EWA-Mechatronics/ME462-Project/README.md

# ME462-Project
Middle East Technical University ME462 - Mechatronic Design Project; Mobile Robot Arena
