EWA-Mechatronics/ME462-Project/Robot/CAD/Readme.md

STL files to be 3D printed and the assembly video is available.  
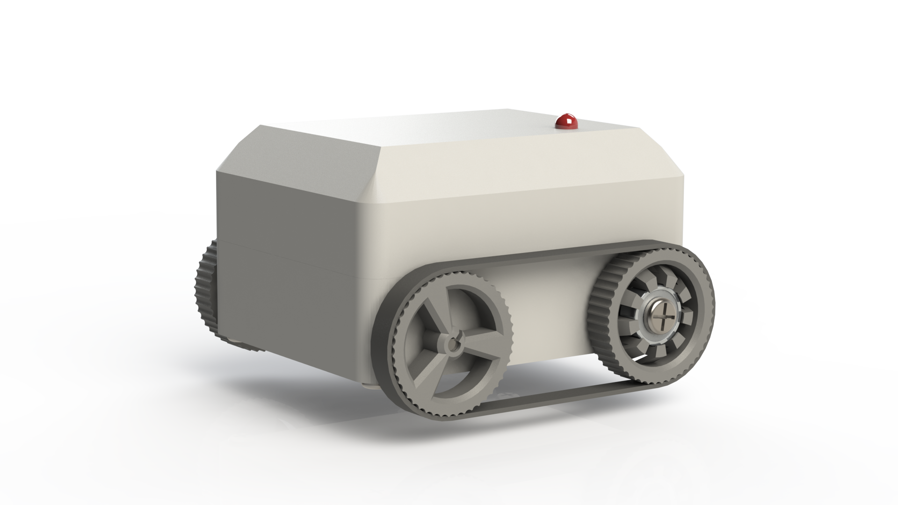
[picture p1: Robot/CAD/render1.png]
  
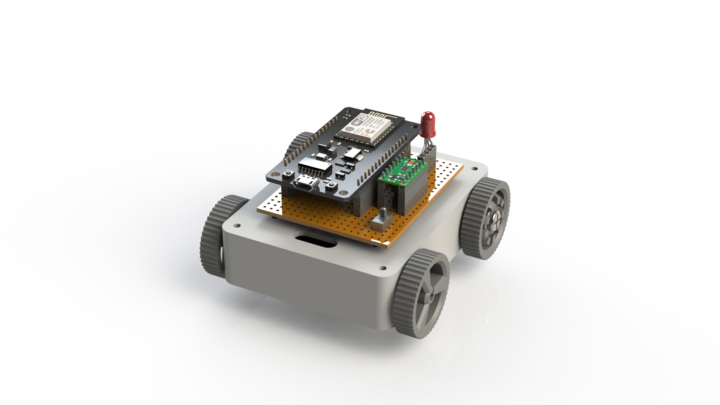
[picture p2: Robot/CAD/render2.png]
