EWA-Mechatronics/ME462-Project/Morphological-Solutions-for-Arena&Robot-Types.md

# Morphological Solutions for Arena&Robot Types

  1. Scenario adapter device
      - Projector
      - Monitor
      
  2. Robot Type
      - Classical
      - Dummy
      
  3. Image Capture Tool
      - Camera
      
  4. Charging of Robots
      - Changeable Battery
      - Laser-beam
      - Magnetic Resonance Coupling
      
  5. Physical Arena Type
      - Frictionless Area
      - Ground (Cathode)
      - Conveyor
      - Monitor
