EWA-Mechatronics/ME462-Project/Functional-Decomposition-for-Arena&Robot-Types.md

# Functional Decomposition for Arena&Robot Types

  1. Scenario adapter device

  2. Robot Type

  3. Image Capture Tool

  4. Charging of Robots

  5. Physical Arena Type
