EWA-Mechatronics/ME462-Project/Software/Webots.md

# What is Webots ?

Webots is a open source professional mobile robot simulation software package. 
It offers a rapid prototyping environment, that allows the user to create 3D virtual worlds with physics properties.
Users can add obstacles and robots to the simulation. Moreover, robots may be equipped with a number of sensor and actuator devices,
such as distance sensors, drive wheels, cameras, motors, touch sensors, etc.
Finally, users can program each robot individually.

Please, visit the [User Guide](https://cyberbotics.com/doc/guide/index) of the Webots to have a deeper understanding.

# Getting Started to the Webots

It is essantial to understand the Webots to understandü this project, since in this project we will also build a simulaiton
to simulate the same processes from the real world. Moreover, we will use this simulation to get desired sensor values. Finally, we want to use
the power of being the open source with Webots.

Please, visit the offical [Tutorials](https://cyberbotics.com/doc/guide/tutorials) of the Webots to get basic understandings about Webots.
