EWA-Mechatronics/ME462-Project/Robot/Functional Decompositon & Morphological Chart.md

**Mobile Robot Functional Decomposition**
1. Actuating the wheels to move
2. To store power
3. Microcontroller
4. To recharge itself
5. To indicate status

**Concepts**
1. Actuating the wheels to move
    1. DC Geared Motor
    2. RC Servo Motor
    3. Stepper Motor

2. To store power
    1. 18650 Li-ion Battery
    2. 14500 Li-ion Battery
    3. Li-Po Battery of appropriate size

3. Microcontroller
    1. Arduino Nano
    2. Raspberry Pi Zero
    3. NodeMCU
    4. ESP-12E

4. To recharge itself
    1. Wireless charger
    2. Physical Contact Charge

5. To indicate status
    1. Addressable LED (NeoPixel)
    2. RGB LED
    3. Buzzer

**Morphological Chart**

| **Functions / Solutions** | 1 | 2 | 3 | 4 |
| --- | :---: | :---: | :---: | :---: |
| 1. Actuating the wheels to move | DC Geared Motor | RC Servo Motor |Stepper Motor|
| 2. To store power | 18650 Li-ion Battery | 14500 Li-ion Battery | Li-Po Battery |  
| 3. Microcontroller | Arduino Nano | Raspberry Pi Zero | NodeMCU | ESP-12E |
| 4. To recharge itself | Wireless charger | Physical Contact Charge |
| 5. To indicate status | Addressable LED | RGB LED | Buzzer |
