EWA-Mechatronics/ME462-Project/Robot/robot-circuit-diagram.png

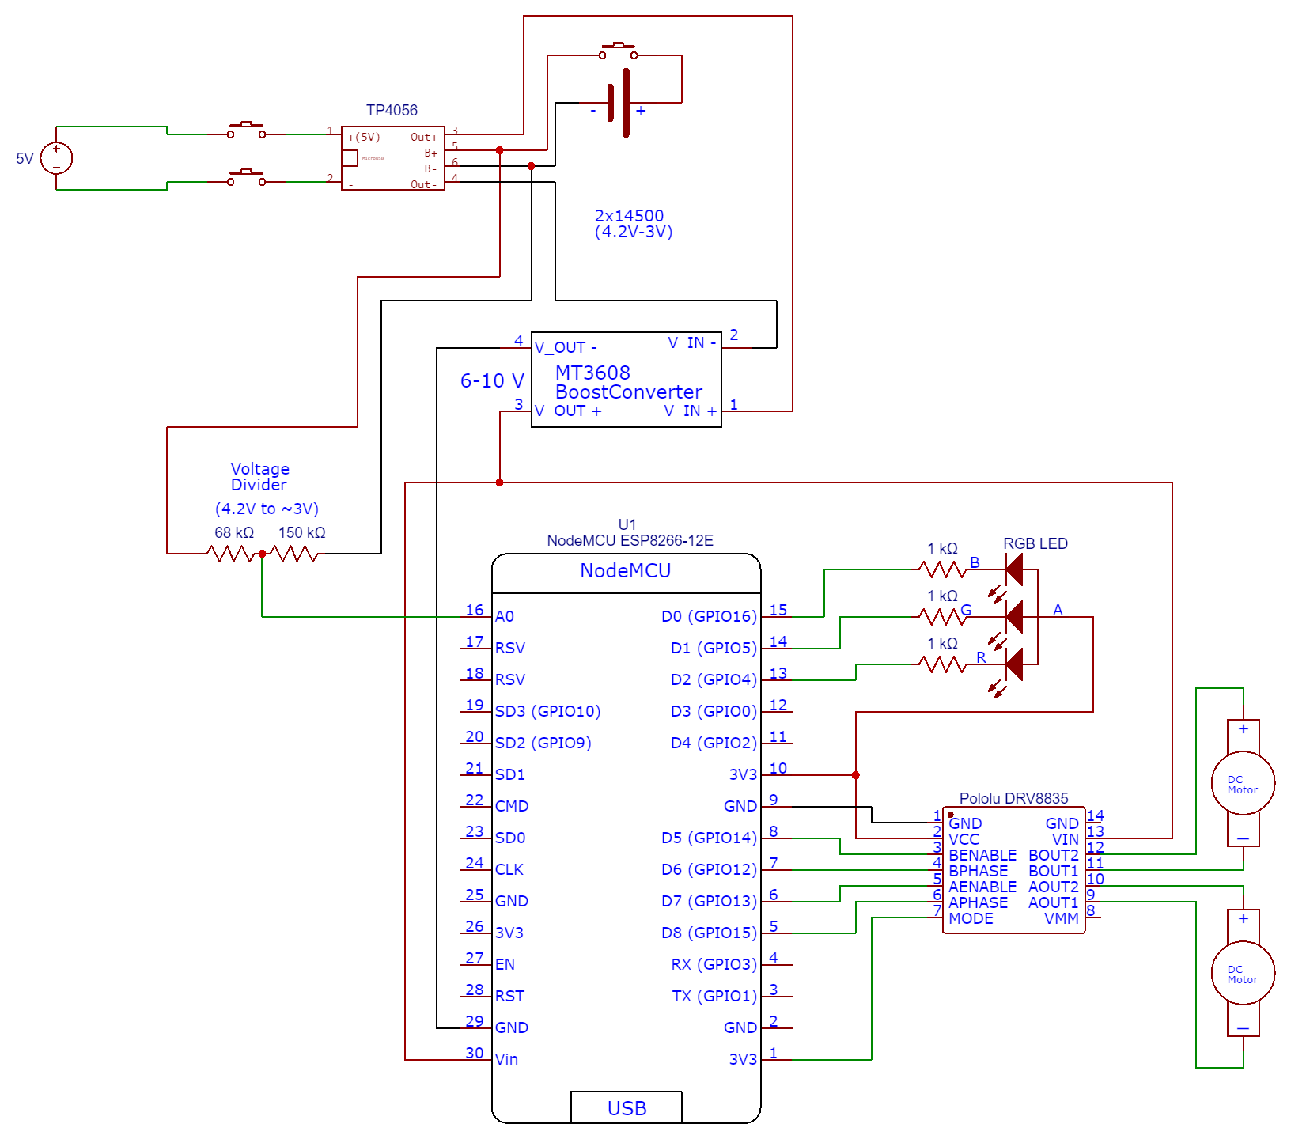
Robot/robot-circuit-diagram.png
