EWA-Mechatronics/ME462-Project/Software/MQTT/mqtt_communication_diagram.png

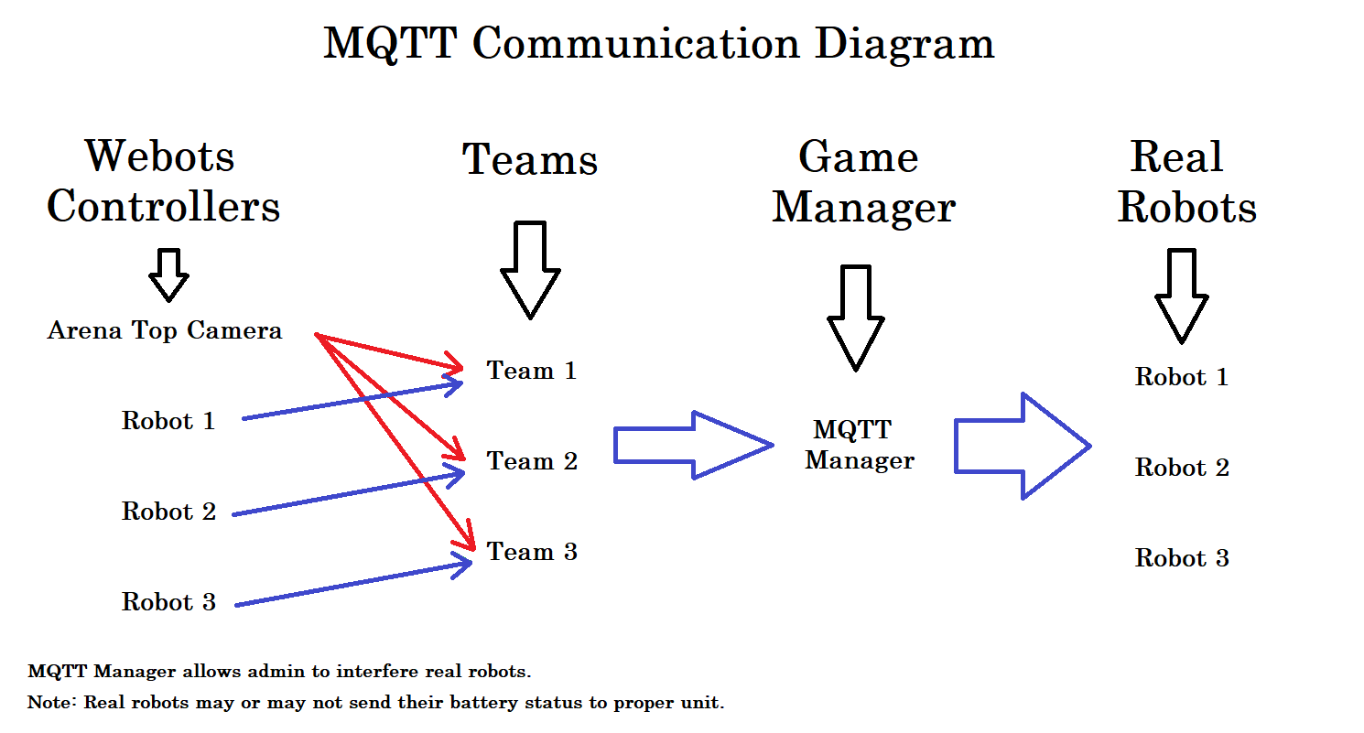
Software/MQTT/mqtt_communication_diagram.png
