EWA-Mechatronics/ME462-Project/Robot/Bill_of_Materials.md

# Bill of Materials

| |Quantity|Sample Link* |Price (₺) |
|---|:---:|---|---:|
|NodeMCU ESP8266 | 1 |[https://www.direnc.net/v3-nodemcu-wifi-gelistirme-modulu](https://www.direnc.net/v3-nodemcu-wifi-gelistirme-modulu)|24.28|
|(Pololu) DRV8835 ** | 1 |[https://www.robitshop.com/urun/cift-motor-surucu-karti-drv8835](https://www.robitshop.com/urun/cift-motor-surucu-karti-drv8835)|34.32|
|Micro Metal Gearmotor - 6V - ?RPM| 2 |[https://www.robotistan.com/6v-350rpm-reduktorlu-mikro-dc-motor](https://www.robotistan.com/6v-350rpm-reduktorlu-mikro-dc-motor)|36.41|
|14500 AA Li-ion Battery 3.7V| 2 |[https://www.pilsitesi.com/orion-14500-aa-li-ion-3-7v-900mah-sarjli-lityum-ka_5247.html](https://www.pilsitesi.com/orion-14500-aa-li-ion-3-7v-900mah-sarjli-lityum-ka_5247.html)|20.00|
|Battery Holder (2 AA) | 1 |[https://www.robotistan.com/2li-aa-pil-yuvasi](https://www.robotistan.com/2li-aa-pil-yuvasi)|1.39|
|MT3608 Boost Converter | 1 |[https://www.robotistan.com/ayarlanabilir-voltaj-yukseltici-kart-step-up-converter](https://www.robotistan.com/ayarlanabilir-voltaj-yukseltici-kart-step-up-converter)|4.99|
|TP4056 Lithium Battery Charger w/ Protection Module| 1 |[https://urun.n11.com/arduino-urunleri-ve-setleri/tp4056-korumali-lityum-pil-sarj-devresi-micro-usb-P403728964](https://urun.n11.com/arduino-urunleri-ve-setleri/tp4056-korumali-lityum-pil-sarj-devresi-micro-usb-P403728964)|3.77|
|GT2 Closed Loop Belt - 200mm| 2 |[https://www.robolinkmarket.com/gt2-kapali-kayis-200mm](https://www.robolinkmarket.com/gt2-kapali-kayis-200mm)|9.23|
|Perfboard (DOT PCB) - 5x6cm | 1 |[https://www.robotistan.com/5x10cm-perforated-pertinax](https://www.robotistan.com/5x10cm-perforated-pertinax)|1.94|
|RGB LED - 5mm | 1 |[https://www.robocombo.com/5mm-Seffaf-RGB-LED](https://www.robocombo.com/5mm-Seffaf-RGB-LED)|0.69|
|Resistors - 68k, 150k, 3x1k | 1 |?|~0|
|Washer - M4 | 4 |?|~0|
|Sliding Switch | 1 |[https://www.direnc.net/surgulu-on-off-switch-180](https://www.direnc.net/surgulu-on-off-switch-180)|0.57|
|Female Headers | 2 |[https://www.robotistan.com/1x40-180-disi](https://www.robotistan.com/1x40-180-disi)|1.06|
|Ball Bearing - 624ZZ | 2 |[https://www.robolinkmarket.com/3d-yazici-rulmani-624zz](https://www.robolinkmarket.com/3d-yazici-rulmani-624zz)|3.24|
|Bolt - M4x20mm | 2 |?|~0.10|
|Bolt - M3x20mm | 4 |[https://www.robotistan.com/m3-20mm-ysb-yildiz-silindirik-bas-metrik-vida-10-adet](https://www.robotistan.com/m3-20mm-ysb-yildiz-silindirik-bas-metrik-vida-10-adet)|0.09|
|Bolt - M3x10mm | 4 |[https://www.robotistan.com/m3-10mm-ysb-yildiz-silindirik-bas-metrik-vida-10-adet](https://www.robotistan.com/m3-10mm-ysb-yildiz-silindirik-bas-metrik-vida-10-adet)|0.07|
|Bolt - M3x6mm | 2 |[https://www.robotistan.com/m3-6mm-ysb-yildiz-silindirik-bas-metrik-vida-10-adet](https://www.robotistan.com/m3-6mm-ysb-yildiz-silindirik-bas-metrik-vida-10-adet)|0.06|
|Nut - M3 | 4 |?|~0.30|
|Nut - M4 | 2 |[https://www.robotistan.com/m4-somun-50li-paket-71002](https://www.robotistan.com/m4-somun-50li-paket-71002)|0.33|
|Washer - M3 | 4 |[https://www.robotistan.com/m3-pul-50-adet](https://www.robotistan.com/m3-pul-50-adet)|0.01|
|Washer - M4 | 4 |?|~0.01|
|Standoff M3 3mm | 4 |[https://www.robotistan.com/q-3mm-m3-metal-disi-disi-aralayici-standoff](https://www.robotistan.com/q-3mm-m3-metal-disi-disi-aralayici-standoff)|0.33|
|Neodymium Magnet - 4mmx1.5mm | 4 |[https://miknatis.gen.tr/index.php?_route_=daire-miknatis&product_id=173](https://miknatis.gen.tr/index.php?_route_=daire-miknatis&product_id=173)|0.30|
|||Total;|₺217.25|

*The links are provided to give an idea about the component and its pricing.  
**Other Dual DC Motor drivers can also be used. Some alternatives; [DRV8833](https://www.robotsepeti.com/drv8833-dual-motor-driver-carrier-drv8833-ikili-motor-surucu-tasiyicisi), [A4990](https://www.direnc.net/a4990-cift-motor-surucu-modulu-pololu), [TB6612FNG](https://www.direnc.net/tb6612fng-dual-motor-driver-carrier-pololu), [L298 Mini](https://www.direnc.net/l298-mini-dc-ve-step-motor-surucu-modulu)
