EWA-Mechatronics/ME462-Project/(commit log)

2020-03-01 Project Schedule - Gantt Chart
    Needs to be updated
    [Project Schedule.xlsx]
2020-03-12 Create Battery Life Estimate.md
2020-04-22 Add files via upload
    Gantt Chart - Updated
    [Project Schedule.xlsx]
2020-07-21 A link to the assembly video is added.
2020-07-31 Rename circuit diagram file
2020-08-02 Mobile Robot CAD files are uploaded
2020-08-02 Assembly video is uploaded
2020-08-02 STL files are uploaded
2020-08-02 Update Readme.md for CAD model
